mgarczyk/moving-platform/Dokumentacja/Elementy.xlsx

Lp. | Nazwa | Ilość | Cena
1 | Rock 4 C+ Radxa RS114CP-D4 4 GB 6 x 1.5 GHz, 1.0 GHz (https://www.conrad.pl/pl/p/rock-4-c-radxa-rs114cp-d4-4-gb-6-x-1-5-ghz-1-0-ghz-2623433.html) | 1 | 449.00 zł
2 | 99:1 METAL GEARMOTOR 25DX69L LP 6V 48 CPPOLOLU (https://www.tme.eu/en/details/pololu-4827/dc-motors/pololu/99-1-metal-gearmotor-25dx69l-lp-6v-48-cp/) | 4 | 452.00 zł
3 | Cytron MDD20A - dwukanałowy sterownik silników DC 30V/20A (https://botland.com.pl/sterowniki-silnikow-moduly/18881-cytron-mdd20a-dwukanalowy-sterownik-silnikow-dc-30v-20a-38515324.html) | 2 | 390.00 zł
4 | Laserowy czujnik odległości Lidar TFmini-S UART/I2C 12m (https://botland.com.pl/czujniki-time-of-flight/15862-laserowy-czujnik-odleglosci-lidar-tfmini-s-uarti2c-12m-5903351249058.html) | 1 | 225.00 zł | s
5 | Koła Dagu Wild Thumper 120x60mm - 2szt. (https://botland.com.pl/kola-z-oponami/2119-kola-dagu-wild-thumper-120x60mm-2szt-6952581600060.html) | 2 | 169.80 zł
6 | Akumulator żelowy 12V 3,4Ah Xtreme (https://botland.com.pl/akumulatory-zelowe/3947-akumulator-zelowy-12v-34ah-xtreme-5900804003281.html) | 1 | 62.90 zł
7 | Silnik krokowy JK42HS40-0404 200 kroków/obr 12V/0,4A/0,4Nm (https://botland.com.pl/silniki-krokowe/6424-silnik-krokowy-jk42hs40-0404-200-krokowobr-12v04a04nm-5904422334604.html) | 1 | 59.90 zł
8 | Serwo PowerHD HD-1800A - micro (https://botland.com.pl/serwa-typu-micro/2314-serwo-powerhd-hd-1800a-micro-6953524540085.html) | 1 | 19.90 zł
9 | Przetwornica step-down XL4015 1,3V-36V 5A (https://botland.com.pl/przetwornice-step-down/8103-przetwornica-step-down-xl4015-13v-36v-5a-5904422336202.html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) | 3 | 60.00 zł
10 | Sterownik silnika krokowego A4988 RepRap (https://botland.com.pl/sterowniki-silnikow-krokowych/2660-sterownik-silnika-krokowego-a4988-reprap-czerwony-5904422359201.html) | 1 | 17.90 zł
11 | US100 ultradźwiękowy czujnik odległosci (https://media.digikey.com/pdf/Data%20Sheets/Adafruit%20PDFs/4019_Web.pdf) | 4 | 40.00 zł
12 | RPLiDAR A1M8-R6 360 (https://botland.com.pl/skanery-laserowe/19625-skaner-laserowy-rplidar-a1m8-r6-360-stopni-12m-seeedstudio-114992561-5904422369248.html) | 1 | 399 zł
13 | Siłownik elektryczny Super Power Jack 2000N 7,5mm/s 24V - wysuw 15cm (https://botland.com.pl/silowniki-liniowe/19268-silownik-elektryczny-super-power-jack-2000n-75mms-24v-wysuw-15cm-5904422362027.html) | 1 | 199 zł
14 | Cyrtron MD10-POT - jednokanałowy sterownik do silnika liniowego (https://botland.com.pl/sterowniki-silnikow-moduly/13450-cytron-md10-pot-sterownik-silnikow-dc-30v10a-przelacznik-potencjometr-5904422377274.html) | 1 | 60 zł
15 | UART MULTIPLEXER (https://www.mikroe.com/uart-mux-click) | 1 | 60 zł
16 | Pleksi 8mm (https://allegro.pl/oferta/plexiglas-pleksiglas-8mm-na-wymiar-10696761064?fromVariant=10696761201) | 3 | Zależna od wymiarów
Suma |  |  | 2664.40 zł
