mgarczyk/moving-platform/mqtt_pub.py

import json
import time
from paho.mqtt import client as mqtt_client

try:
    with open ("config.json") as config_f:
        config = json.load(config_f)
        BROKER = config["MQTT_BROKER"]
        PORT = config["MQTT_PORT"]
        config_f.close()
except FileNotFoundError:
    print("Brak pliku konfiguracyjnego.")
    exit()


def connect_mqtt(client_id : str, broker : str, port : int) -> mqtt_client:
    def on_connect(client, userdata, flags, rc):
        if rc == 0:
            print("Connected to MQTT Broker!")
        else:
            print("Failed to connect, return code %d\n", rc)
    client = mqtt_client.Client(client_id)
    client.on_connect = on_connect
    client.connect(broker, port)
    return client

def publish(client : mqtt_client, topic : str, message):
    result = client.publish(topic, message)
    status = result[0]
    if status == 0:
        print(f"Send `{message}` to topic `{topic}`")
    else:
        print(f"Failed to send message to topic {topic}")

#Use code below to test pub<->sub communcation.

def test_run(client_id : str, broker : str, port : int , topic):
    client = connect_mqtt(client_id, broker, port)
    i = 0
    while True:
        i+=1
        time.sleep(0.1)
        publish(client, topic, i)

if __name__ == '__main__':
    client_id = "publish-test"
    topic = "mqtt/test"
    try:
        test_run(client_id, BROKER, PORT, topic)
    except KeyboardInterrupt:
        print("Connection ended")
        exit()
