mgarczyk/moving-platform/(commit log)

2023-07-05 Program to extract data from US 100 sensors
2023-07-06 us100
    wstępne do 2.5cm
2023-07-07 Sensory us100
2023-07-10 Working on both UART's US100 sensors.
2023-07-11 Program for US100 sensors testing.
2023-07-12 Stepper motor test script.
2023-07-14 Script for testing tfmini LIDAR.
2023-07-14 Script for testing US100 with UART's.
2023-07-14 Stepper motor testing script.
2023-07-19 Lidar test
2023-07-20 Motor step
2023-07-20 Script to publish into MQTT broker
    [mqtt_pub.py]
2023-07-20 Script for read data from MQTT broker.
    [mqtt_sub.py]
2023-07-21 After tests of first prototype with stepper motor.
2023-07-28 Script for connect with camera and send photo MQTT
2023-07-28 Function that allow to send cv2 photo to MQTT broker.
    [mqtt_camera.py]
2023-08-02 Steering
    Merged functionality PWM with MQTT
2023-08-02 Script for steering platform motors.
2023-08-04 Script for steering the platform.
2023-08-16 DC PWM steereing script.
2023-08-18 Script for read data from encoders.
2023-08-18 Platform pinout.
    [Pinout_platform_v8.xlsx]
2023-08-21 Minor fixes e.g topics names, some comments etc.
    [encoder.py, height.py]
2023-08-28 Script for steering motors via Arduino.
2023-09-04 Script for steering platform manually.
2023-09-04 Scripts for read from encoders in the same time.
2023-09-05 Scripts for read from encoders.
2023-09-05 LIDAR to mqtt.
2023-09-06 Add the flag that reset state of encoders.
    [left_enc.py, right_enc.py]
2023-09-06 Script for autonomus robot steering.
2023-09-07 Pretest autonomous driving with obstacle avoiding.
    [auto.py]
2023-09-08 Early version of obstacle avoiding was added.
    [auto.py]
2023-09-08 PWM init - run it in ~ directory by, ./init.sh
2023-09-18 PWM init file.
2023-09-18 Stop motors after init.
2023-09-18 Moved to other place.
    [Pinout_platform_v8.xlsx]
2023-09-19 Changes in pinout,
    [Pinout_RockPi.xlsx]
2023-09-19 Changes from using 2 PWMs to one.
2023-09-20 Scripts for control robot with use of Arduino UNO.
2023-09-20 Minor fixes, mqtt channels priority etc.
    [left_enc.py, right_enc.py]
2023-09-20 DC motor model change.
    [Elementy.xlsx]
2023-09-21 Second PWM added.
2023-09-22 Names changes.
    [MQTT_kanaly.xlsx]
2023-09-22 PWM and soft start changes.
2023-09-25 Pinout changes
    [Pinout_RockPi.xlsx]
2023-09-27 Topic name changes.
    [MQTT_kanaly.xlsx]
2023-09-27 Added steering via config.
2023-10-02 Encoders to arduino.
    [Pinout_RockPi.xlsx]
2023-10-02 Some bugs fix, like forward() in loop.
    [auto.py]
2023-10-02 Bug fixes like forward() inside loop, etc.
    [auto.py]
2023-10-02 Encoders reading moved to arduino.
2023-10-02 Bug fixes, added config.
    [us100.py]
2023-10-02 Funcionality moved to Arduino.
2023-10-02 Reading encoders on Arduino and send to Raspberry
2023-10-02 Test scrip for reading arduino serial on raspberry,
2023-10-10 Added distance reading from encoders via Arduino.
2023-10-10 Script for UART watching.
2023-10-10 Lidar script.
2023-10-16 Channels changes.
    [MQTT_kanaly.xlsx]
2023-10-16 Corrections for straight drive and 90deg turn added.
    [main.ino]
